solipsia/QuizMaster/images/EDP32devkitv1 pinout.webp

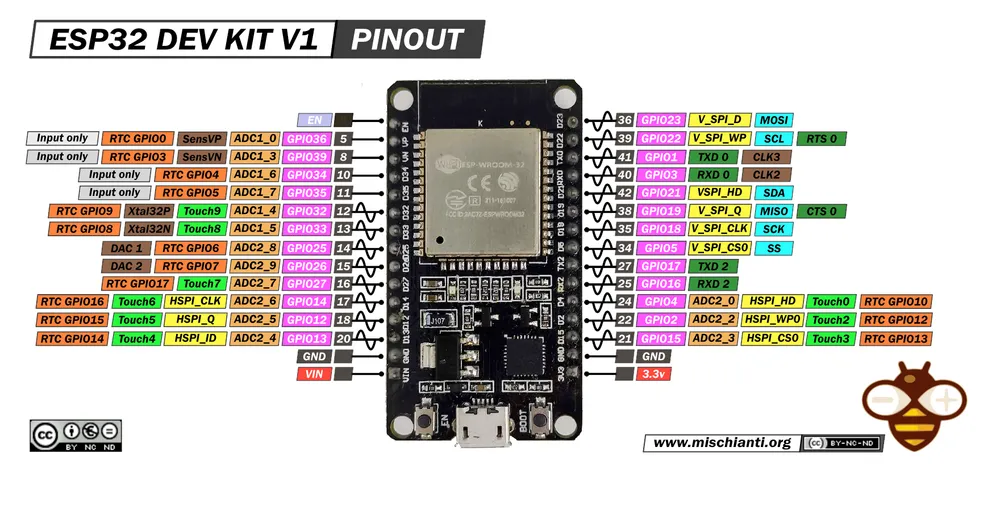
images/EDP32devkitv1 pinout.webp
