solipsia/QuizMaster/enclosure/QuizMaster.3mf

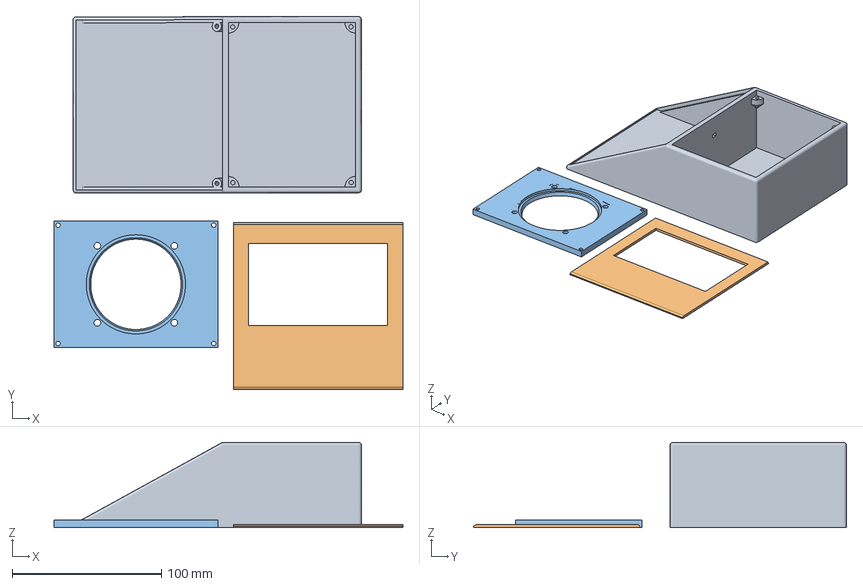
[picture p2: CAD file, 2026-03-19]
enclosure/QuizMaster.3mf
233.6 x 249.7 x 57.0 mm
Speaker - Box.stl
Speaker - Face.stl
Speaker - Lid.stl
