solipsia/QuizMaster/(commit log)

2026-03-14 feat: add List Models button to discover available Gemini models
2026-03-14 fix: rate limit backfill worker — 7s delay between generations, honour 429 retry-after
2026-03-14 fix: reduce generation delay to 3s for 30 RPM free tier limit
2026-03-14 feat: worker pause/resume — manual buttons + auto-pause after 3 consecutive errors
2026-03-14 fix: use Python 3.11 — piper-phonemize has no py3.12 wheels
2026-03-17 docs: hardware design updates — pin swap, battery ADC, amp on 5V, print-ready diagram
    - Reassign pins for cleaner wiring: amp signals (SD→D32, DIN→D33) to
    left side near amp, touch signals (T_CS→D21, T_IRQ→D4) to right side
    near display, display RST→D16. Swap BCLK/LRC (D25/D26) to eliminate
    wire crossing.
    - Add battery voltage monitoring: 100kΩ+100kΩ divider from battery B+
    to GPIO 35 (ADC1_CH7).
    - Move amp VIN from 3.3V to 5V rail for ~1.8W output (was ~0.5W).
    - Set amp GAIN to float (12dB) instead of GND (9dB).
    - Add wiring diagram SVG: print-friendly light mode with white
    background, connections reference table replacing legend.
    - Update TFT_eSPI config: TFT_RST=16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
2026-03-18 feat: update firmware pin assignments, add display/touch test sketch
    Update speaker_test and quiz_test pin mappings to match current hardware
    design (BCLK→25, LRC→26, DIN→33, AMP_SD→32). Switch speaker_test from
    square wave to sine wave. Add volume attenuation to quiz_test. Add new
    display_test sketch for ILI9488 + XPT2046 touch validation. Document
    touch Y-axis inversion workaround in CLAUDE.md.
    [display_test.ino, quiz_test.ino, speaker_test.ino]
2026-03-18 feat: add configurable splash screen welcome voice
    Adds a "Splash Screen Voice" text setting (default: "Welcome to Quiz Master")
    to the config page. The service synthesizes TTS audio on first request and
    caches it. The device fetches and plays this clip during the splash screen
    on power-up.
2026-03-18 feat: faster welcome audio, working TTS test, voice/rate dropdowns
    - Firmware plays welcome audio immediately on WiFi connect (direct URL,
    no JSON round-trip). Service pre-generates welcome.wav on startup.
    - Config page: Test TTS button now works — synthesizes a phrase and plays
    it in the browser with an audio element.
    - Voice Model changed from textbox to dropdown with curated US/GB English
    Piper voices. Sample Rate changed to dropdown (16kHz / 22.05kHz).
    - Welcome audio regenerated on config save when text changes.
2026-03-18 fix: voice dropdown auto-saves, larger answer text, audio cutoff fix
    - Voice Model dropdown triggers config save on change so Test TTS
    immediately uses the newly selected voice.
    - Answer screen font doubled from 12pt to 24pt.
    - DMA flush delay increased from 300ms to 700ms to prevent the last
    ~0.5s of audio being cut off (DMA holds ~0.56s at 22050 Hz).
    [quizmaster.ino]
2026-03-18 feat: add Groq provider, auto-save config, spend analytics, fix list-models
    - Add Groq as dedicated provider in dropdown with defaults
    (llama-3.1-8b-instant, GROQ_API_KEY)
    - Update Claude defaults (claude-haiku-4-5, ANTHROPIC_API_KEY)
    - Auto-save on every config change (debounced for text, immediate for
    selects/radios), remove Save/Reset buttons
    - Add Spend Analytics panel to dashboard showing API calls and token
    usage grouped by provider/model
    - Fix list-models bug: was hardcoded to Google AI, now provider-aware
    (POST with form config, supports all providers)
    - Fix list-models triggering spurious "Configuration saved" notification
    - Track token usage in all LLM clients (Claude, Goog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
2026-03-19 feat: category selection screen, easter egg mode, replay buttons, fix display colors
    Device firmware:
    - Replace main screen QUIZMASTER text with category selection grid
    (fetched from service, each category tappable to enable/disable)
    - Add replay buttons next to Reveal Answer and Next Question
    - Category button now navigates back to category selection screen
    - Header badge shows enabled count (ALL / N/M / NONE)
    - Fix display colors: keep invertDisplay(true) active permanently
    so standard RGB values from design spec render correctly
    Quiz service backend:
    - Add easter egg system: configurable Q&A injected into quiz
    responses at a set probability, with pre-generated TTS audio
    - Add disab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
    [quizmaster.ino]
2026-03-19 fix: send all enabled categories to quiz API, add error screen nav
    - Firmware sends comma-separated list of enabled categories instead
    of randomly picking one — fixes "No Questions Ready" when pool has
    questions for other enabled categories
    - Pool.pop() supports comma-separated category matching
    - Error screen now has CATEGORY + RETRY split buttons
    - Tapping category badge on error screen returns to category selection
    - Add URL encoding for category names and serial logging for fetch
    - Show HTTP code and category on error screen for diagnostics
    [quizmaster.ino]
2026-03-19 fix: update generator config on all saves, bold category badge, grid sizing
    - Always update generator.config on config save, not just when LLM
    changes — fixes worker generating old categories after editing
    - Show current question's category in bold in header badge
    - Category grid buttons: max 42px tall (fits 4 rows), Font 4 text
    [quizmaster.ino]
2026-03-19 feat: device config screen with volume, flush queue, QR code web app link
    - Add Settings screen on device (tap WiFi icon): volume slider, flush
    queue button, provider/model display, and Web App QR code
    - Volume control replaces hardcoded -6dB attenuation (0-100%, default 70%)
    - QR code screen uses ESP-IDF qrcode API to display configurable app URL
    - Add MiscellaneousConfig with app_url field to service config
    - Add Miscellaneous section to web config UI between Device and Token Pricing
    - Add functional design doc, enclosure files, logo assets, blink test sketch,
    pinout reference image, and wiring diagram updates
    [QuizMaster.3mf]
2026-03-19 feat: low battery protection + ADC warmup fix
    Warm up ADC with throwaway reads at startup to fix intermittent "---"
    voltage display. Add low battery cutoff at 3.3V: synthesizes and plays
    "Battery Low" voice, then shuts down amp, WiFi, and touch input,
    showing voltage on a red/black screen that refreshes every 30s.
    [quizmaster.ino]
2026-03-20 fix: set default volume to 30%
    [quizmaster.ino]
2026-03-21 feat: embedded SFX audio, auto-sizing answer text, question dedup
    - Embedded sound effects system: PROGMEM C arrays played via I2S, no
    WiFi needed. Includes welcome jingle and ready-to-answer chime.
    - Auto-size answer text (24pt → 18pt → 12pt) so long answers fit.
    - Track last 50 questions in prompt to prevent LLM repeats, persisted
    to /data/recent_questions.json across restarts.
    - Switch to huge_app partition (3MB app) for SFX headroom.
    [quizmaster.ino]
2026-03-21 fix: add recent questions dashboard panel, fix prefetch SFX playback
    - Add GET /api/admin/recent endpoint for dedup question history
    - Add Recent Questions panel to dashboard (polled every 5s)
    - Fix missing play_sfx call on prefetched question path
    [quizmaster.ino]
